YiangG/MyESP32DevBoard/README.md

# MyESP32DevBoard
My custom ESP32-WROOM-32E thin dev board
