YiangG/MyESP32DevBoard/BOM/Bill of Materials-ESP32MyDevBoard.xlsx

Line # | Name | Description | Designator | Revision ID | Revision State | Revision Status | Quantity | Manufacturer 1 | Manufacturer Part Number 1 | Manufacturer Lifecycle 1 | Supplier 1 | Supplier Part Number 1 | Supplier Unit Price 1 | Supplier Subtotal 1
1 | CAP 0805 22UF 10V 20% X5R | Capacitor Surface Mount 0805 Footprint 22UF 10V 20% Tolerance Ceramic X5R | C1, C2, C8 | CMP-011-000507-1 | Draft | Up to date | 3 | Murata | GRM21BR61A226ME51L | Volume Production | LCSC | C77074 | 0.0358 | 0.716
2 | CAP 0402 0.1UF 16V 10% X7R | Capacitor Surface Mount 0402 Footprint 0.1UF 16V 10% Tolerance Ceramic X7R | C3, C5, C6, C7, C9, C10, C11, C12 | CMP-011-000043-1 | Draft | Up to date | 8 | Yageo | CC0402KRX7R7BB104 | Volume Production | Jak Electronics | CC0402KRX7R7BB104 | 0.00027 | 0.0027
3 | CAP 0603 4.7UF 10V 10% X5R | Capacitor Surface Mount 0603 Footprint 4.7UF 10V 10% Tolerance Ceramic X5R | C4 | CMP-011-000329-1 | Draft | Up to date | 1 | Yageo | CC0603KRX5R6BB475 | Volume Production | Utmel Electronic | 898-CC0603KRX5R6BB475 | 0.0174 | 0.0174
4 | LSM0805412V | Single Color LED, RED, 0805 | D1 | CMP-00026-00001-1 | Draft | Up to date | 1 | Visual Communications | LSM0805412V | Volume Production | Arrow Electronics | LSM0805412V | 0.2041 | 0.2041
5 | LSM0805452V | Single Color LED, Green, 0805 | D2 | CMP-00038-3 | Production | Up to date | 1 | Visual Communications | LSM0805452V | Volume Production | Corohmni | LSM0805452V | 0.207 | 0.207
6 | LESD5D5.0CT1G | Transient Voltage Suppressors for ESD Protection | D3, D4, D5 |  | Not managed |  | 3 | LRC | LESD5D5.0CT1G | Unknown | LCSC | C383211 | 0.0185 | 0.925
7 | BAT760-7 | Diode Schottky 30V 1A 2-Pin SOD-323 T/R | D6 |  | Not managed |  | 1 | Diodes | BAT760-7 | Volume Production | Corohmni | BAT760-7 | 0.051 | 0.051
8 | TSW-117-23-T-S | CONN HEADER VERT 17POS 2.54MM | J1, J3 | CMP-02766-001472-1 | New From Design | Up to date | 2 | Samtec | TSW-117-23-T-S | Volume Production | Avnet | TSW-117-23-T-S | 1.43 | 2.86
9 | 473460001 | CONN RCPT USB2.0 MICRO B SMD R/A | J2 | CMP-2000-05246-2 | New From Design | Up to date | 1 | Molex | 47346-0001 | Volume Production | Newark | 47M0505 | 0.365 | 0.365
10 | ESP32-WROOM-32E(M113EH3200PH3Q0) | RX TXRX MOD WIFI TRACE ANT SMD | MD1 | CMP-194065-000012-1 | New From Design | Up to date | 1 | Espressif Systems | ESP32-WROOM-32E(M113EH3200PH3Q0) | Unknown | Digi-Key | 1965-ESP32-WROOM-32E-N4TR-ND | 3 | 1950
11 | SS8050-G | NPN TRANSISTOR 1.5A 40V SOT-23 R | Q2, Q3 | CMP-20235-000001-1 | New From Design | Up to date | 2 | Comchip | SS8050-G | Volume Production | Jak Electronics | SS8050-G | 0.02508 | 0.05016
12 | RES 0402 1K 1% | Resistor Surface Mount, 1K Ohms, 0402 Footprint, 1% Tolerance 0.063W | R1, R2 | CMP-005-000571-1 | Draft | Out of date | 2 | Yageo | AC0402FR-071KL | Volume Production | Utmel Electronic | 898-AC0402FR-071KL | 0.00132 | 0.00264
13 | RES 0402 560 1% | Resistor Surface Mount, 560 Ohms, 0402 Footprint, 1% Tolerance 0.063W | R3 | CMP-005-001506-1 | Draft | Out of date | 1 | Yageo | RC0402FR-07560RL | Volume Production | Utmel Electronic | 898-RC0402FR-07560RL | 0.00084 | 0.00084
14 | RES 0402 10K 1% | Resistor Surface Mount, 10K Ohms, 0402 Footprint, 1% Tolerance 0.063W | R4, R5, R6, R13 | CMP-005-000226-1 | Draft | Out of date | 4 | Yageo | RC0402FR-0710KP | Volume Production | One Stop Electro | RC0402FR-0710KP | 0.006 | 0.024
15 | RES 0402 22.1K 1% | Resistor Surface Mount, 22.1K Ohms, 0402 Footprint, 1% Tolerance 0.063W | R7 | CMP-005-000735-1 | Draft | Out of date | 1 | Yageo | RC0402FR-0722K1L | Volume Production | Utmel Electronic | 898-RC0402FR-0722K1L | 0.00084 | 0.00084
16 | RES 0402 0 5% | Resistor Surface Mount, 0 Ohms, 0402 Footprint, 5% Tolerance 0.063W | R8, R10 | CMP-005-000002-2 | Draft | Out of date | 2 | Yageo | PA0402-R-070RL | Volume Production | NetroFlash | PA0402-R-070RL | 0.037 | 0.074
17 | RES 0402 47.5K 1% | Resistor Surface Mount, 47.5K Ohms, 0402 Footprint, 1% Tolerance 0.063W | R9 | CMP-005-001348-1 | Draft | Out of date | 1 | Yageo | RC0402FR-0747K5L | Volume Production | Quest | RC0402FR-0747K5L | 0.0088 | 0.0088
18 | RES 0402 22 5% | Resistor Surface Mount, 22 Ohms, 0402 Footprint, 5% Tolerance 0.063W | R11, R12 | CMP-005-000731-3 | Draft | Up to date | 2 | Panasonic | ERJ-2GEJ220X | Volume Production | Element14 | 2692418 | 0.00518 | 0.01036
19 | TL3305AF260QG | SWITCH TACTILE SPST-NO 50MA 12V | SW1, SW2 | CMP-17879-000010-1 | New From Design | Up to date | 2 | E-Switch | TL3305AF260QG | Volume Production | Digi-Key | EG5353CT-ND | 0.21 | 0.42
20 | AMS1117-3.3 | LDO Voltage Regulators 1A, 3.3V | U1 | CMP-209535-000001-1 | New From Design | Up to date | 1 | Advanced Monolithic Systems | AMS1117-3.3 | Unknown | Utmel Electronic | 3066-AMS1117-3.3 | 0.17208 | 0.17208
21 | CP2102N-A02-GQFN28R | IC USB TO UART BRIDGE QFN28 | U2 | CMP-08093-000007-1 | New From Design | Up to date | 1 | Silicon Labs | CP2102N-A02-GQFN28R | Volume Production | Mouser | 634-CP2102NA02QFN28R | 4.89 | 4.89
