YiangG/MyESP32DevBoard/Job1.PDF

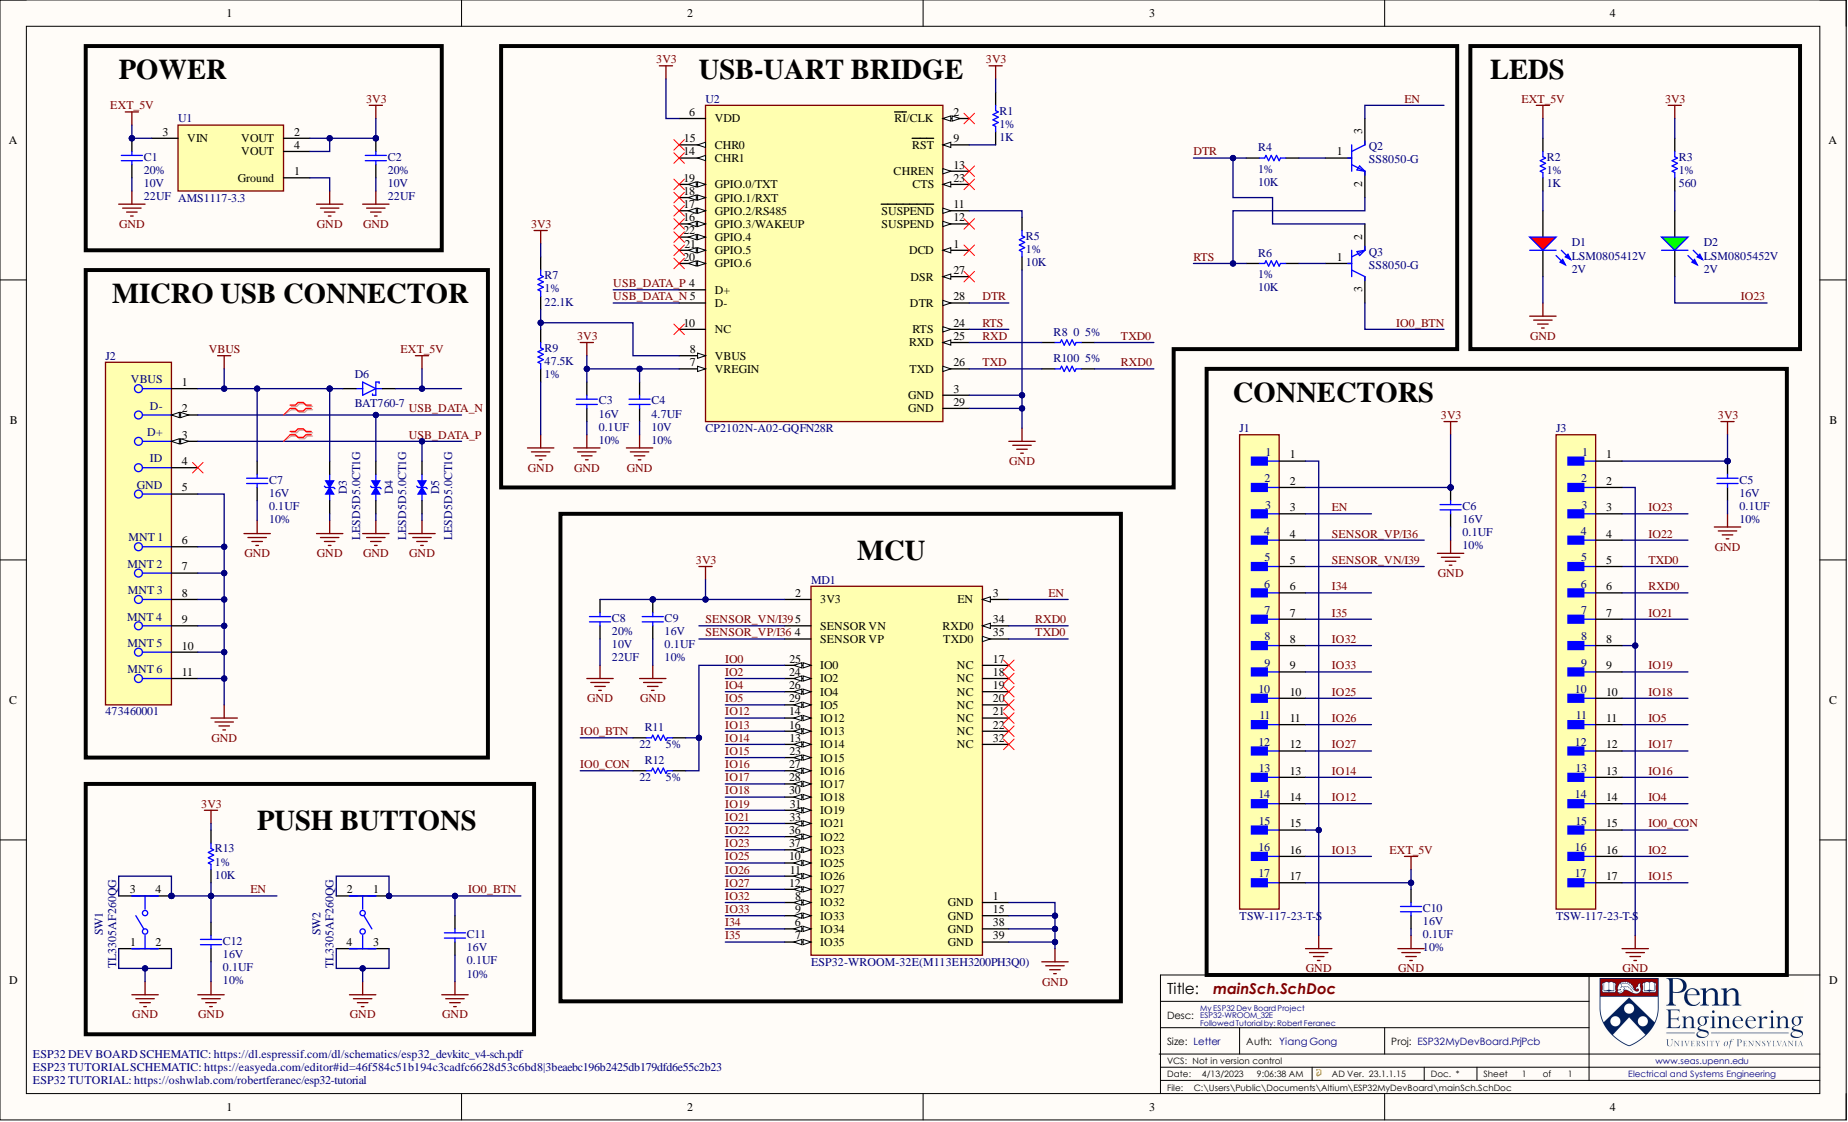
[picture p1: page 1]

USB_ D

SE NSOR_ V N/I 3 9

1 5
3 8
3 9

Not in version control

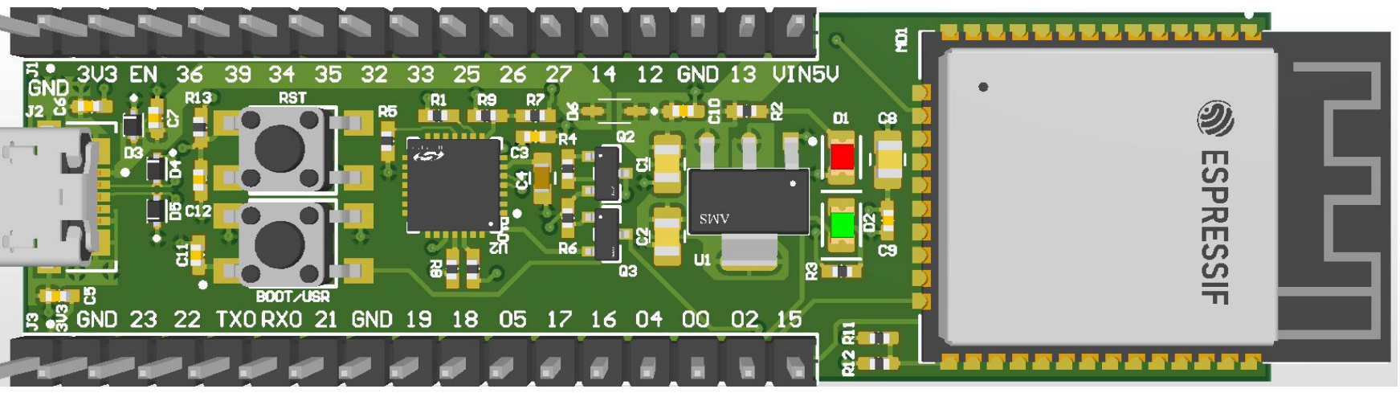
[picture p2: page 2]

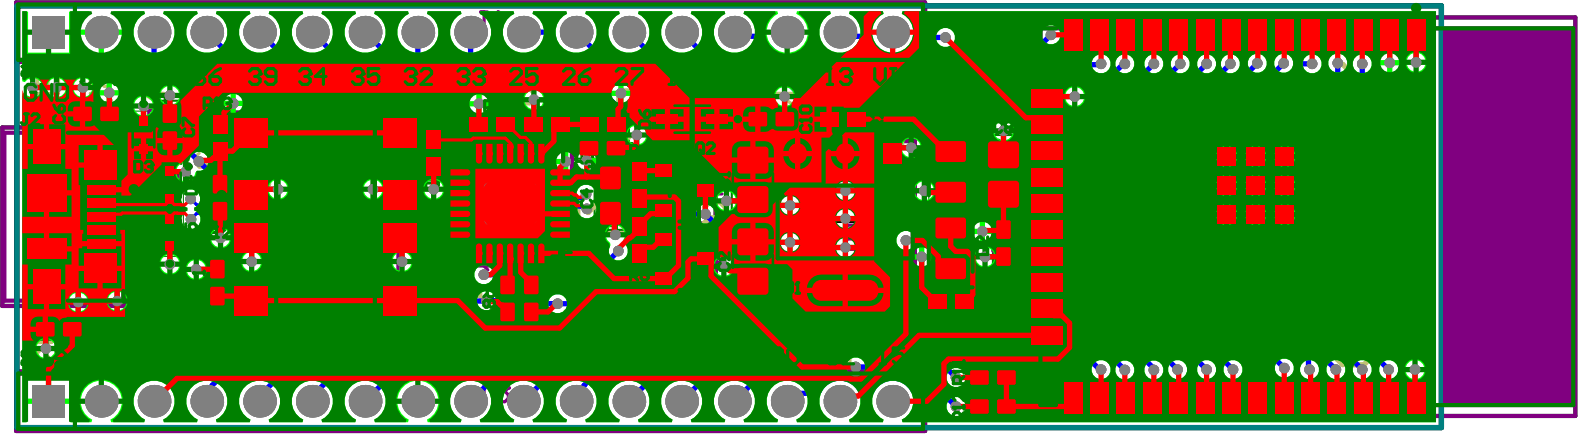
[picture p3: page 3]

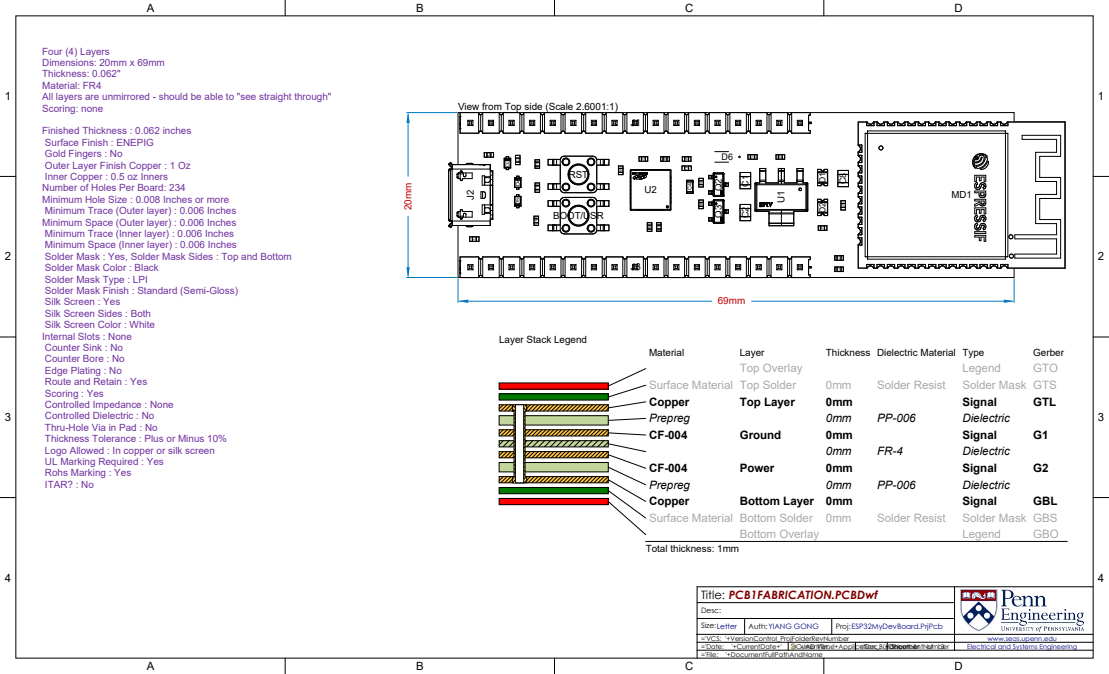
[picture p4: page 4]

All layers are unmirrored - should be able to "see straight through"
Scoring: none

View from Top side (Scale 2.6001:1)

Finished Thickness : 0.062 inches
Surface Finish : ENEPIG
Gold Fingers : No
Outer Layer Finish Copper : 1 Oz
Inner Copper : 0.5 oz Inners
Number of Holes Per Board: 234

Minimum Hole Size : 0.008 Inches or more
Minimum Trace (Outer layer) : 0.006 Inches
Minimum Space (Outer layer) : 0.006 Inches
Minimum Trace (Inner layer) : 0.006 Inches
Minimum Space (Inner layer) : 0.006 Inches
Solder Mask : Yes, Solder Mask Sides : Top and Bottom
Solder Mask Color : Black
Solder Mask Type : LPI
Solder Mask Finish : Standard (Semi-Gloss)
Silk Screen : Yes
Silk Screen Sides : Both
Silk Screen Color : White
Internal Slots : None
Counter Sink : No
Counter Bore : No
Edge Plating : No
Route and Retain : Yes
Scoring : Yes
Controlled Impedance : None
Controlled Dielectric : No
Thru-Hole Via in Pad : No
Thickness Tolerance : Plus or Minus 10%
Logo Allowed : In copper or silk screen
UL Marking Required : Yes
Rohs Marking : Yes
ITAR? : No

www.seas.upenn.edu

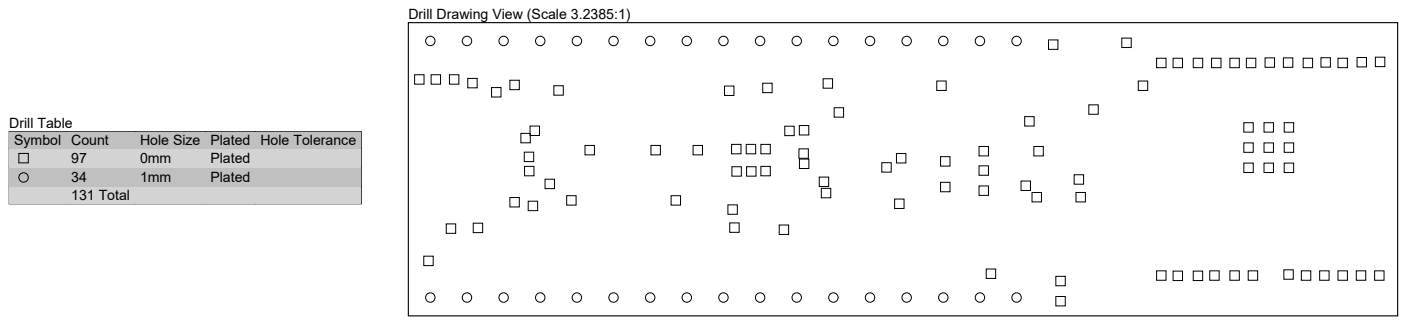
[picture p5: page 5]

Drill Drawing View (Scale 3.2385:1)

Symbol | Count | Hole Size | Plated | Hole Tolerance

97 | 0mm | Plated
34 | 1mm | Plated
131 Total

www.seas.upenn.edu

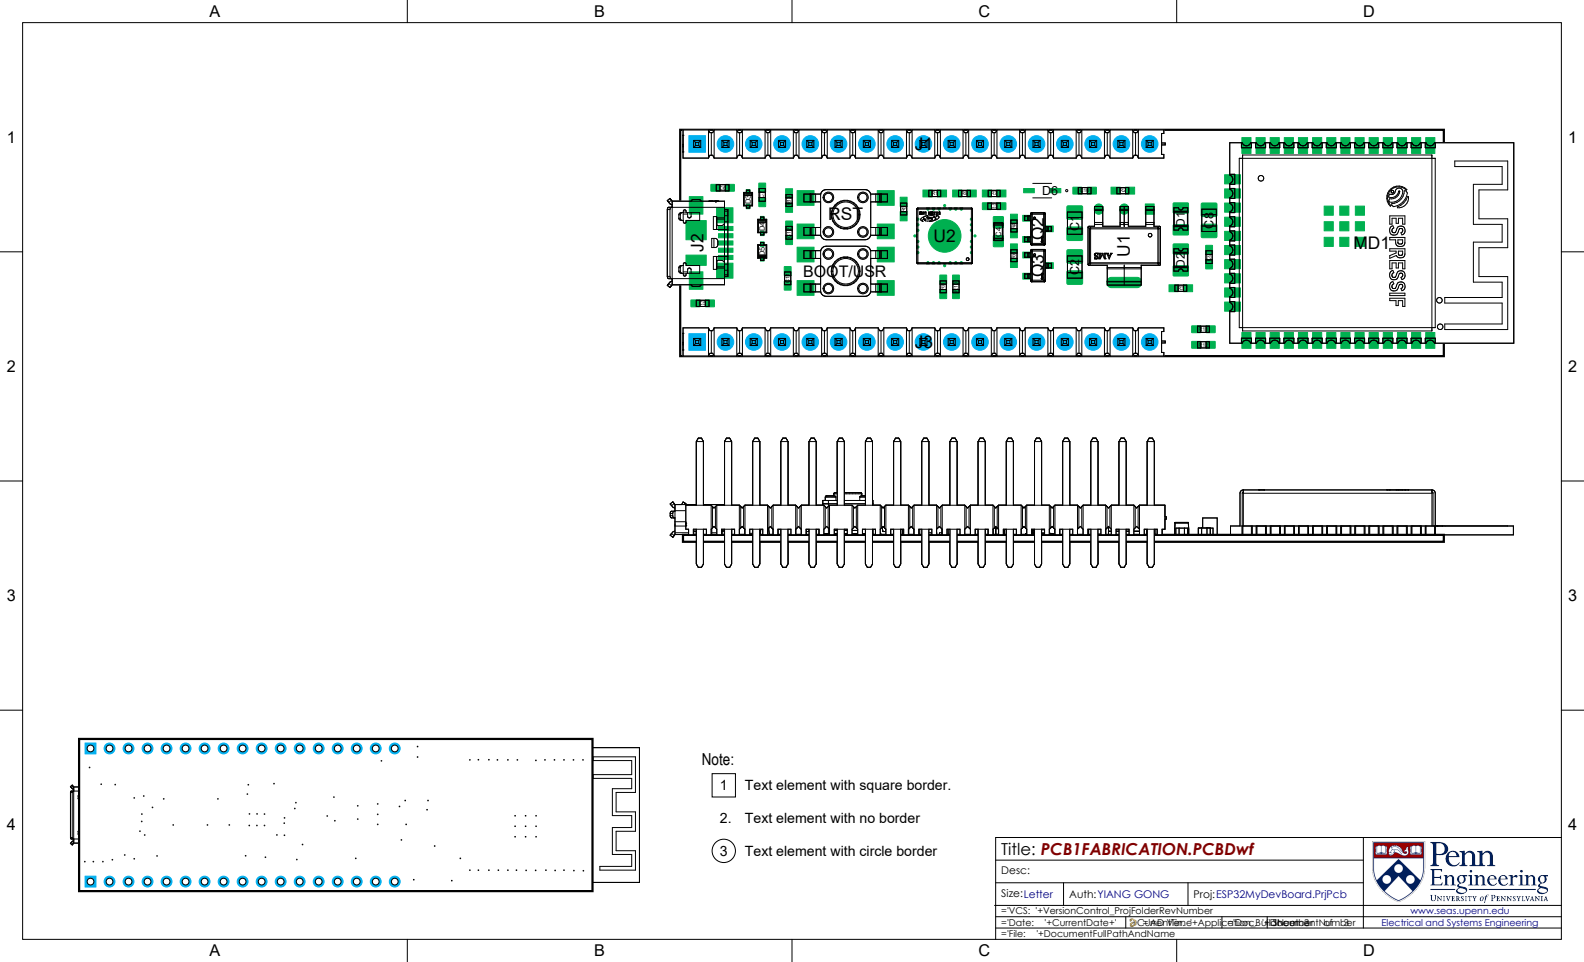
[picture p6: page 6]

Note:
1 Text element with square border.

2. Text element with no border

3 Text element with circle border

www.seas.upenn.edu

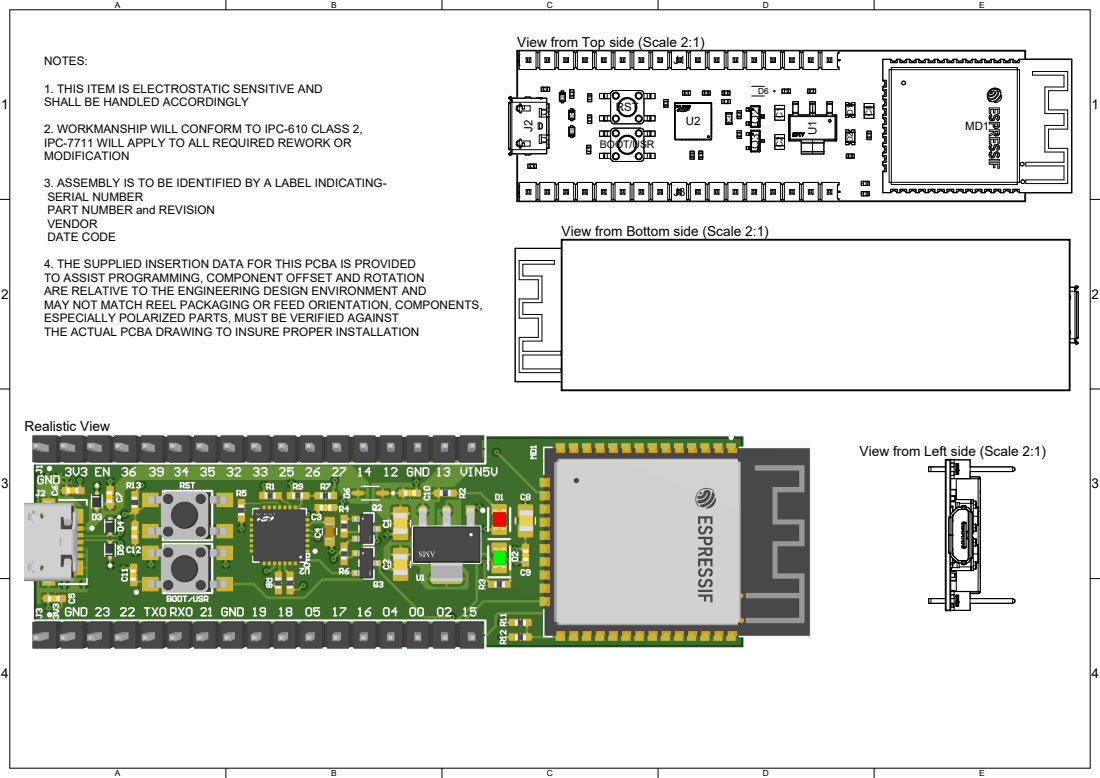
[picture p7: page 7]

View from Top side (Scale 2:1)

1. THIS ITEM IS ELECTROSTATIC SENSITIVE AND
SHALL BE HANDLED ACCORDINGLY

2. WORKMANSHIP WILL CONFORM TO IPC-610 CLASS 2,
IPC-7711 WILL APPLY TO ALL REQUIRED REWORK OR
MODIFICATION

3. ASSEMBLY IS TO BE IDENTIFIED BY A LABEL INDICATING-
SERIAL NUMBER
PART NUMBER and REVISION
VENDOR
DATE CODE

View from Bottom side (Scale 2:1)

4. THE SUPPLIED INSERTION DATA FOR THIS PCBA IS PROVIDED
TO ASSIST PROGRAMMING, COMPONENT OFFSET AND ROTATION
ARE RELATIVE TO THE ENGINEERING DESIGN ENVIRONMENT AND

MAY NOT MATCH REEL PACKAGING OR FEED ORIENTATION, COMPONENTS,
ESPECIALLY POLARIZED PARTS, MUST BE VERIFIED AGAINST
THE ACTUAL PCBA DRAWING TO INSURE PROPER INSTALLATION

View from Left side (Scale 2:1)

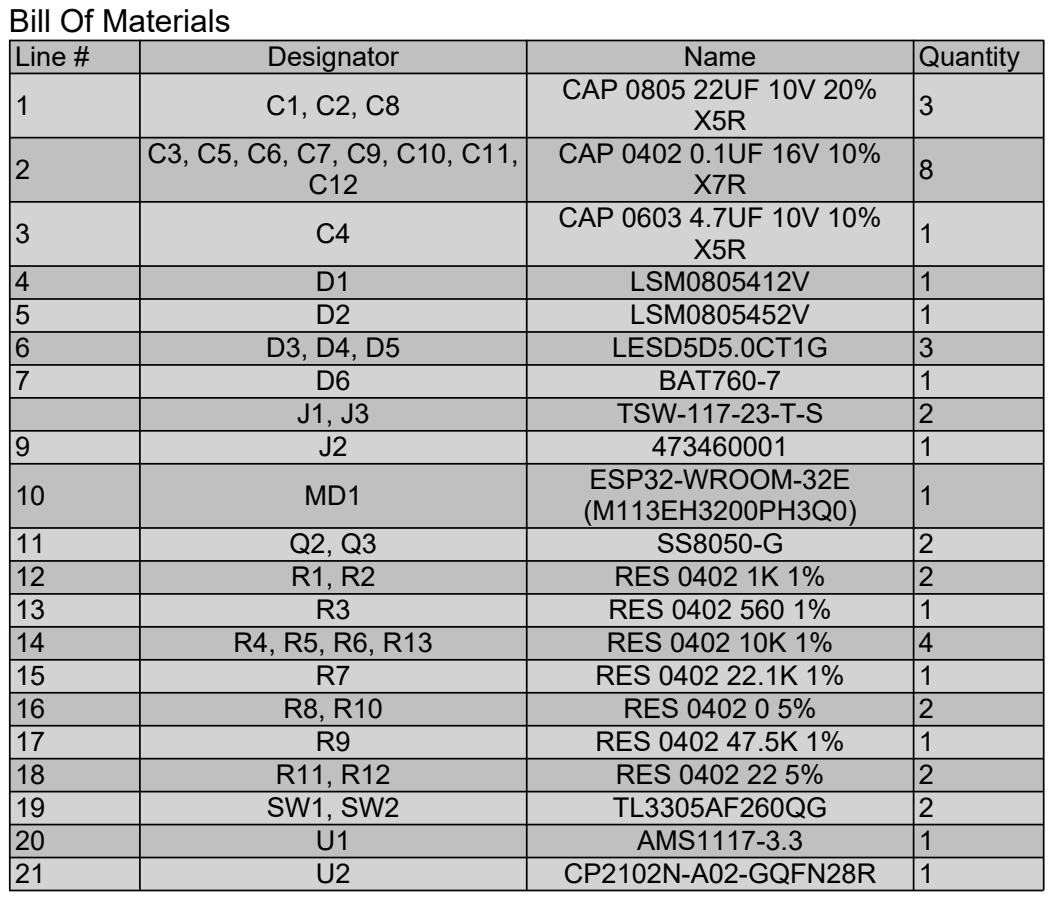
[picture p8: page 8]

Line # 12345679 | C3, C5, C6, C7, C9, C10, C11, C12 | CAP 0402 0.1UF 16V 10% X7R

D2 | LSM0805452V | Quantity 381113121122141212211
Designator | Name
C1, C2, C8 | CAP 0805 22UF 10V 20% X5R

C4 | CAP 0603 4.7UF 10V 10% X5R

D1 | LSM0805412V

D3, D4, D5 | LESD5D5.0CT1G
D6 | BAT760-7
J1, J3 | TSW-117-23-T-S
J2 | 473460001

10 | MD1 | ESP32-WROOM-32E (M113EH3200PH3Q0)

11 | Q2, Q3 | SS8050-G
12 | R1, R2 | RES 0402 1K 1%
13 | R3 | RES 0402 560 1%
14 | R4, R5, R6, R13 | RES 0402 10K 1%
15 | R7 | RES 0402 22.1K 1%
16 | R8, R10 | RES 0402 0 5%
17 | R9 | RES 0402 47.5K 1%
18 | R11, R12 | RES 0402 22 5%
19 | SW1, SW2 | TL3305AF260QG
20 | U1 | AMS1117-3.3
21 | U2 | CP2102N-A02-GQFN28R
